vibheshmodgil/RC_car_version2/(commit log)

2026-07-15 Initial commit: RC Car V2 test bench + Pi integration phase
    - CarTestBench/: ESP32 DevKit firmware (4x TB6612 motors, 4 encoders,
    WiFi AP, web UI with motor/drive/encoder/camera pages, REST + WS API)
    - CamStreamer/: ESP32-CAM MJPEG streamer
    - pi/: Raspberry Pi 4 client modules + smoke tests (BNO055, RPLidar,
    gimbal servos, ESP32 link)
    - Hardware architecture docs (markdown + PDF)
2026-07-15 Add pi/webapp: FastAPI dashboard, the car's main UI (Pi-centric phase A)
    One dark phone page (same design system as the ESP32 fallback UI) with
    e-stop, arm, hold-to-drive D-pad with 300 ms deadman re-send, speed
    slider, per-wheel PWM/RPM, IMU heading + calibration, embedded CAM
    stream with FPS/bitrate, gimbal sliders, and an on-demand LiDAR polar
    plot. One merged telemetry WebSocket (~10 Hz) carries ESP32 + IMU +
    LiDAR + CAM state; every sensor is optional and shows offline when
    missing. Control POSTs are forwarded verbatim to the DevKit so its
    REST API stays the contract. Ships a systemd unit and install docs.
    [config.py]
2026-07-15 Move the WiFi AP to the Pi; DevKit becomes a station at 192.168.4.5
    Phase B of the Pi-centric migration. pi/setup_ap.sh turns the Pi into
    the AP at 192.168.4.1 via NetworkManager shared mode, keeping the same
    SSID/PSK so CamStreamer needs zero changes; phone DHCP pool is
    .100-.200, static boards stay below it (DevKit .5, CAM .10).
    CarTestBench gains WIFI_STATION_MODE in config.h (1 = join the Pi's AP
    with a static IP + non-blocking reconnect watchdog, 0 = legacy self-AP
    as the escape hatch). Its own UI keeps serving at .5 as the debug
    fallback. pi/config.py ESP32_HOST follows the DevKit to .5.
2026-07-15 Add 500 ms drive deadman to CarTestBench (Pi-centric phase C)
    If any wheel has nonzero PWM and no /api/drive or /api/motor pwm
    command has arrived for DRIVE_DEADMAN_MS (config.h, 500 ms), all
    wheels coast and the event is logged to Serial — non-blocking millis()
    check in loop(). Wheels stay armed, so the next command drives again.
    The drive page already re-sent its held direction every 300 ms; the
    motors page now re-sends any nonzero slider on the same cadence so
    bench testing keeps working, and its help text explains the auto-stop.
2026-07-16 Document the Pi-centric architecture (md + PDF) and update all guides
    New 'Hardware Architecture - Pi Centric.md' + matching PDF: topology,
    IP plan (Pi .1 / DevKit .5 / CAM .10 / phones .100-.200), AP setup,
    firmware modes, layered safety with the 500 ms deadman, boot and
    migration/flash order, and a diff table vs the superseded phase. The
    Pi Integration Phase doc is marked superseded for network topology and
    corrected to the real LiDAR hardware (YDLIDAR X2, not the RPLidar
    placeholder); both PDFs are regenerated to match. CLAUDE.md and the
    root README reflect the new roles, IP plan, deadman, pi/webapp, and a
    clear per-board file-placement guide.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
2026-07-16 Replace placeholder IMU/LiDAR drivers with proven bench-tested code
    pi/imu.py and pi/lidar.py were unverified placeholders (Adafruit
    CircuitPython BNO055, rplidar-roboticia for an RPLidar A1/C1). Ported
    in the actual working drivers from a separate bench-tested prototype:
    BNO055 read via raw smbus2 register writes (no CircuitPython/Blinka
    dependency chain) and a YDLIDAR X2 raw serial packet parser (no vendor
    SDK). Both keep the existing pi/ module conventions — fail-fast
    constructor, background thread, latest-value snapshot — so hub.py,
    main.py and the smoke tests only needed their call sites updated to
    the new Imu.reading dict / Lidar.scans() point-list shape, not a
    redesign. config.py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
    [config.py, imu.py, lidar.py, main.py]
2026-07-20 Switch car to home WiFi, rebuild Pi dashboard as a test bench, fix drive stutter
    Retire the Pi-hosted WiFi AP (192.168.4.x, pi/setup_ap.sh) in favor of all
    three boards joining the house WiFi router directly as stations with
    static IPs (192.168.1.50/.51/.52, pi/setup_wifi.sh). The AP had been the
    main source of flaky bring-up; home WiFi also means phones no longer need
    to switch networks to reach the car.
    - Reorganize all "Hardware Architecture" docs into docs/hardware-architecture/
    with version numbers (v1 original as-built, v2 Pi integration phase, v3
    Pi-centric AP - both superseded, v4 = current home-WiFi doc).
    - Add from-scratch, non-coder-friendly READMEs for every board
    (CarTest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
    [AppServer.cpp, CamStreamer.ino, WebUI.h, config.h, config.py, gimbal.py]
2026-07-21 Add optional ROS2 (Jazzy) bridge node on the Pi
    New ros2_ws/src/car_bridge node reuses pi/esp32_link.py, pi/imu.py, and
    pi/lidar.py unchanged to expose cmd_vel/estop/imu/scan over ROS2,
    without touching the DevKit or CAM firmware or the REST/WS contract.
    Requires reimaging the Pi to Ubuntu Server 24.04 for official ROS2
    Jazzy packages; docs updated accordingly (new v5-ros2-bridge.md primer
    plus pi/README.md and pi/RESUME_GUIDE.md updates). Not yet run on real
    hardware.
